captaincoder777/Airplane-custom-transmitter-and-receiver-/README.md

# Custom RC Aircraft System (Arduino Nano & NRF24L01)
A custom-built remote-controlled airplane made from scratch using 5mm sun Board runs on an srduino sano uses an NRF24L01 radio module for communication. The plane has a 3-channel control system that manages throttle through a brushed ESC via ailerons and pitch using the elevator. Everything is controlled from a hand-built ground station transmitter.

## Project Motivation

Most people jump into this hobby using made radio systems and foam planes i wanted to build everything from the ground up by designing both the aircraft and the transmitter by my self  learned how flight dynamics work , how wireless radios communicate , how microcontroller firmware operates , how to model parts in CAD and how to cut boards by hand i also got experience with power distribution , signal routing and fixing hardware problems during test flights.  

# CAD design
the build start from here 

this is where the aircraft comes to live 

this is final build 

the motor will slide here 

and is connected to receiver


airframe here thw sings have two ailerons which will move simultaneously mirrored when one is up other is down same other side which will help the aircraft to turn left ad right

the elevator helps the aircraft to pitch up and down 

## Receiver circuit and CAD
Screenshot 2026-10-31 at 6 50 51 PM

follow this path to connect the components

| Component | Pin | Connected To | 
| :-- | :-- | :-- |
| **NRF24L01** | VCC / VSS | Arduino 3.3V |
| **NRF24L01** | GND | Arduino GND |
| **NRF24L01** | CE | Arduino D7 |
| **NRF24L01** CSN | Arduino D8 |
| **NRF24L01** | MOSI | Arduino D11 |
| **NRF24L01** | MISO | Arduino D12 |
| **NRF24L01** | SCK | Arduino D13 |
| **Aileron Servo** | Signal | Arduino D2 |
| **Aileron Servo** |+/-| 5V Rail / GND |
| **Elevator Servo** | Signal | Arduino D4 |
| **Elevator Servo** |+/-| 5V Rail / GND |
| **Brushless ESC** | Signal | Arduino D5 |
| **Brushed ESC** | BEC Red | Arduino 5V |
|**Brushed ESC** | BEC Black | Arduino GND |

the full assembly will look like this 


held inside an enclosure which goes on board the flight

## Transmitter circuit and CAD
the transmitter i held in a box to make this look good


this is the final build has screws to hold them intact here the anteena nrf module and nano is one single component after build which can be kept and removed when necessary 
Screenshot 2026-10-31 at 6 55 05 PM
and batteries can be swapped 

the circuit design goes like this 

Screenshot 2026-10-31 at 6 57 54 PM

follow this path to solder 
| Component | Pin| Connected To |
| :-- | :-- | :-- |
| **NRF24L01** | VCC/VSS | Arduino 3.3V |
| **NRF24L01** | GND | Arduino GND |
| **NRF24L01** | CE | Arduino D7 |
| **NRF24L01** CSN | Arduino D8 |
| **NRF24L01** | MOSI | Arduino D11 |
| **NRF24L01** | MISO | Arduino D12 |
| **NRF24L01** | SCK | Arduino D13 |
| **Right Joystick (J1)** | VRX | Arduino A1 |
| **Right Joystick (J1)** | VRY Arduino A2 |
| **Right Joystick (J1)** | VCC / GND 5V / GND Rail |
| **Left Joystick (J2)** | VRY Arduino A0 |
| **Left Joystick (J2)** | VCC / GND 5V / GND Rail |

this is how the final build looks like 



## Airframe dimensions and CAD
follow this path for measurements 

be carefull while cutting through sun board as you need to use very sharp knife for this.  

| Component | Material | Dimension |
| :-- | :-- | :--
| **Fuselage Sides** | 5mm Sun Board | 50 cm length |
| **Main Wing Panel** | 5mm Sun Board |53 cm wingspan, 8 cm root chord |
| **Horizontal Stabilizer** | 5mm Sun Board | 28 cm span |
| **Vertical Fin** | 5mm Sun Board | 9–10 cm height |

# What goes where


this is final build 



keep the batteries either side to prevent the aircrft from loosing balance up in the air


place one servo near the elevator to help the pudh rod movement correct 

and other at middle to operate both ailerons 



### Control Surface & Hardware Setup

* I cut custom slots in the fuselage to hold two SG90 micro servos. I attached linkages stopper and push rods to the control horns on the ailerons and elevator.

* The 555 motor slide to the nose plate and power wires flow to the 30A ESC , which is mounted on the side wall.

* I placed the 7.4V LiPo battery far forward as possible to keep the center of gravity balanced for stable flight.

### Electronics Assembly Notes

* I soldered socket pins onto a pcb so the Arduino Nano and NRF24L01 could be inserted and removed without soldering.

* I added a 100uF capacitor across the power pins of the NRF24 module to prevent voltage drops.

* All the joystick pots, power input and radio output were wired inside the transmitter box.

## Firmware Setup

* Install the Arduino IDE.

* Use the built-in library manager to install the **RF24** library by TMRh20.

### Upload Procedure

Connect the transmitter Arduino Nano to your PC using USB.

in the Arduino IDE select Arduino Nano as the board Transmitter.ino` choose the correct COM port and click Upload.

swap the Nano board with the unit.

Open `Receiver.ino` confirm the board is correct and upload the code.

## Bill of Materials (BOM)

| Item | Quantity | Aprox. Cost | Link/Source |
| :-- | :-- | :-- | :-- |
| **Arduino Nano**| 2 | $3 | https://robocraze.com/products/nano-board-r3-compatible-with-arduino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|
| **NRF24L01 Transceiver**| 2 | $2 | https://robocraze.com/products/nrf24l01-pa-lna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 |
| **555 Brushed Motor**| 1 | $3 | https://robu.in/product/555-front-and-rear-ball-bearing-motors-dc-24v-12v-12000rpm/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|
| **30A Brushed ESC**| 1 | $7 | https://robu.in/product/30-a-brushed-esc-no-brake/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|
| **LiPo Battery (7.4V 2200 mAh)**| 1 | $1 | https://robocraze.com/products/3-7v-2000mah-18650-li-ion-battery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|
| **SG90 / MG90S Micro Servos**| 2 | $3 | https://robu.in/product/mg90s-9g-servo-metal-gear/ |
| **2-Axis Joystick Modules**| 2 | $1| https://robu.in/product/joystick-module-ps2-breakout-sensor/|
| **Sun Board (5mm)** | 1 Sheet | $7 | https://www.amazon.in/Foam-Board-Sun-Thickness-Size/dp/B0F2SYL8JF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|
| **100uF Capacitors** |2 | $2 | https://robu.in/product/100uf-250v-electrolytic-capacitor-dip-pack-of-2/|
| **Hardware & Linkages (Pushrods, Horns, Wires)**| 1 Set | $10 | https://robu.in/product/d1x700mm-z-type-push-pull-steel-rod-for-rc-aircraft-aero-modelling-2pcs/|
| **Total** | $40(aprox) | 

# Full working video

Video 1: https://youtu.be/rrU_qEG8W9A

Video 2 shows clearly how ailerons and elevator work.  

Video 2: https://youtu.be/Hg1TWhAzz4g

## Hard Lessons & Practical Fixes and Failure

* **Sun Board Snapping:** The 5mm Sun Board is strong under stress but it breaks very hard  at joints when it takes a hard hit nose dives often tear the glue points apart and this made my aircraft to fall off and everything snapped where ever possible.  

* **NRF Voltage Limits:** The NRF24L01 only works at 3.3V. powering it 5V will destroy it instantly(like i did) use 3.3V with capacitors for signal loss.

* **Transmitter Antenna Warning:** Never turn on the NRF module without attaching the antenna without the antenna the this will burn the modeul.
  
* **Power Dip Resets:** When both servos move at speed the power draw can cause the 5V line to drop below 4.2V which  resets the microcontroller add capacitors to avoid these brownouts.

# Credits
* **[Arduino](https://www.arduino.cc/)** - Microcontroller programming
* **[TMRh20 RF24](https://github.com/nRF24/RF24)** - Wireless communication library
* **[GrabCAD](https://grabcad.com/library)** - CAD electronic models for full CAD assembly
* **[Hack Club Forge](https://forge.hackclub.com/)** - For supporting projects in this format
