captaincoder777/Airplane-custom-transmitter-and-receiver-/Circuit/Receiver.png

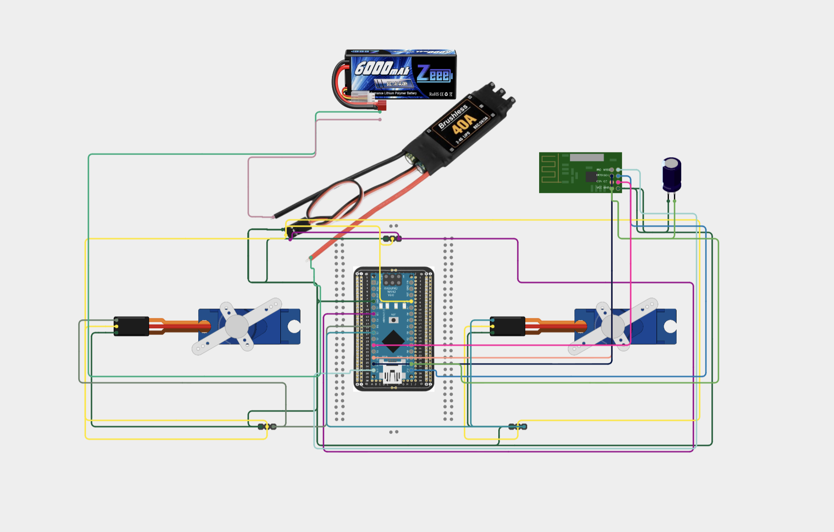
Circuit/Receiver.png
