captaincoder777/Airplane-custom-transmitter-and-receiver-/Circuit/Transmitter.png

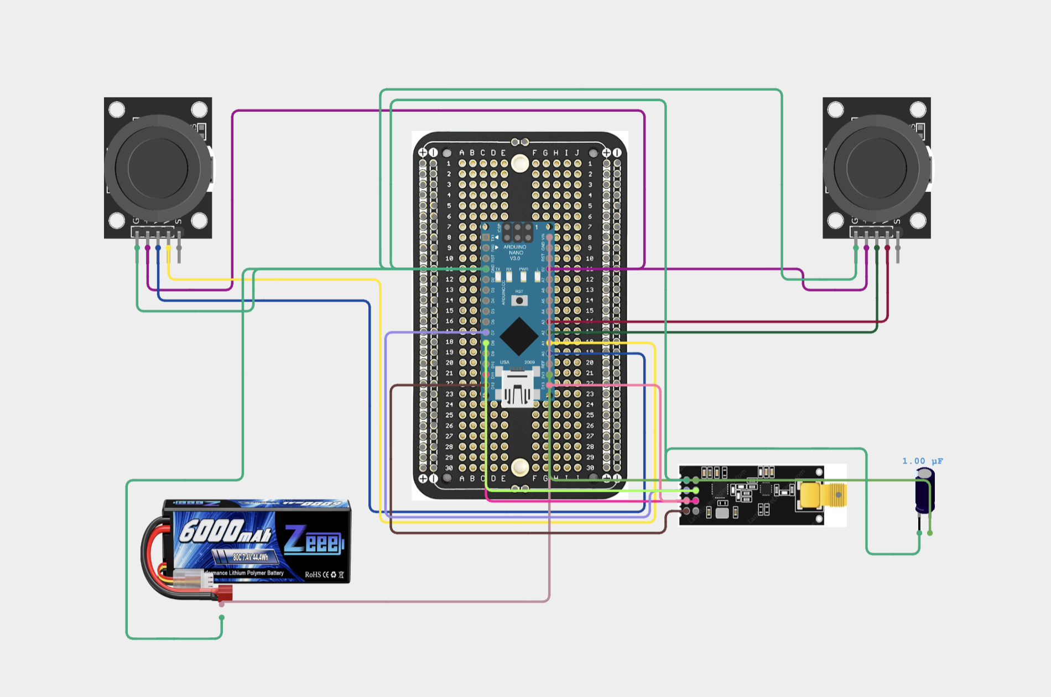
Circuit/Transmitter.png
