captaincoder777/Airplane-custom-transmitter-and-receiver-/CAD /Airframe CAD/Airplanedesign.step

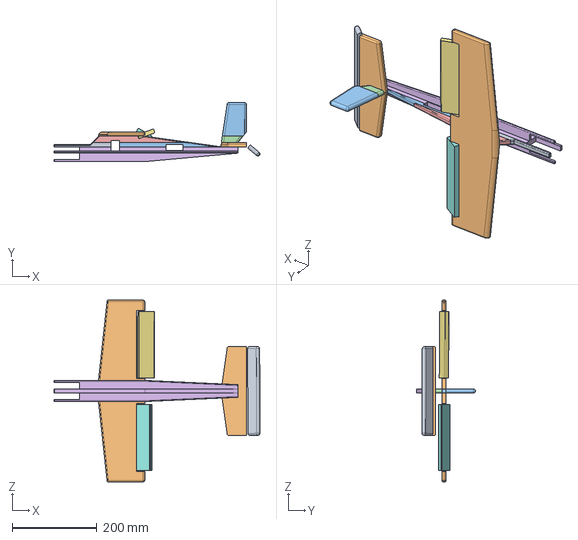
[picture p3: CAD file, 2026-10-31]
CAD /Airframe CAD/Airplanedesign.step
487.1 x 140.0 x 430.0 mm
