captaincoder777/Airplane-custom-transmitter-and-receiver-/CAD /Electronics CAD/Li-ion 18650.SLDPRT

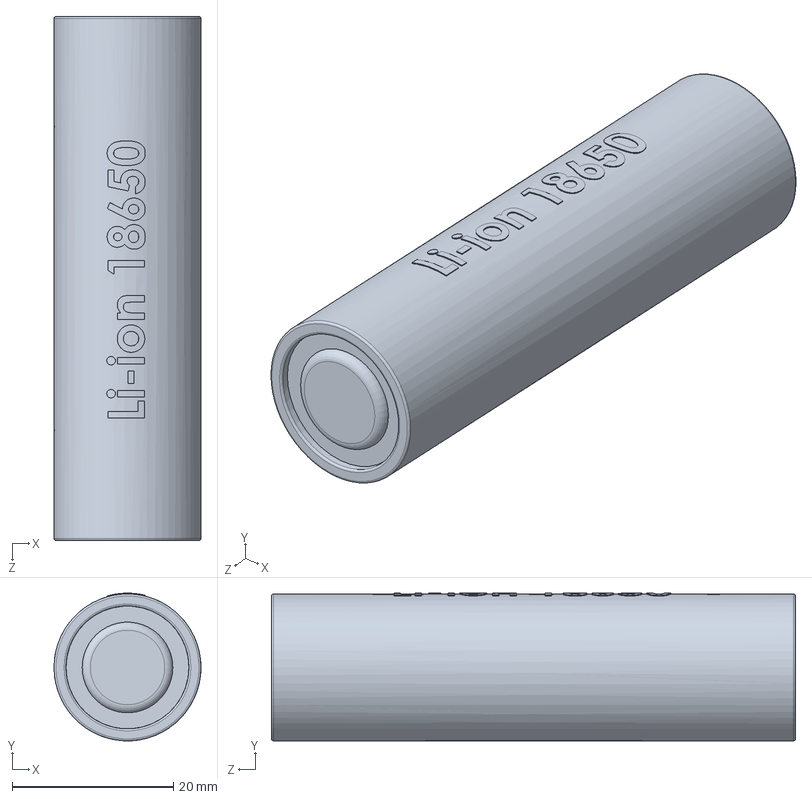
[picture p4: CAD file, 2026-10-31]
CAD /Electronics CAD/Li-ion 18650.SLDPRT
18.2 x 18.3 x 65.1 mm
