captaincoder777/Airplane-custom-transmitter-and-receiver-/CAD /Receiver CAD/Receiver.step

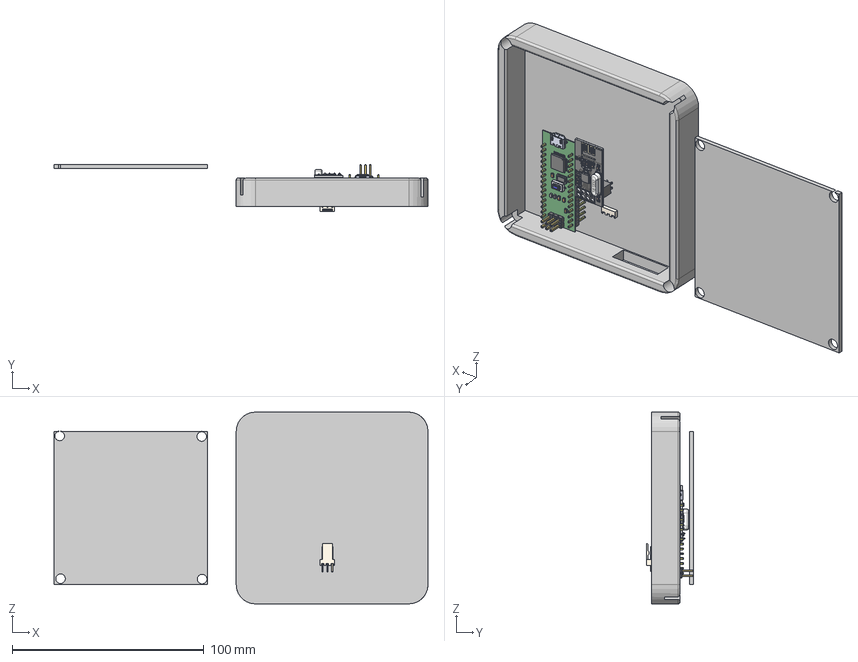
[picture p5: CAD file, 2026-10-31]
CAD /Receiver CAD/Receiver.step
195.0 x 24.5 x 100.0 mm
PCB
