captaincoder777/Airplane-custom-transmitter-and-receiver-/CAD /Transmitter CAD/Body.step

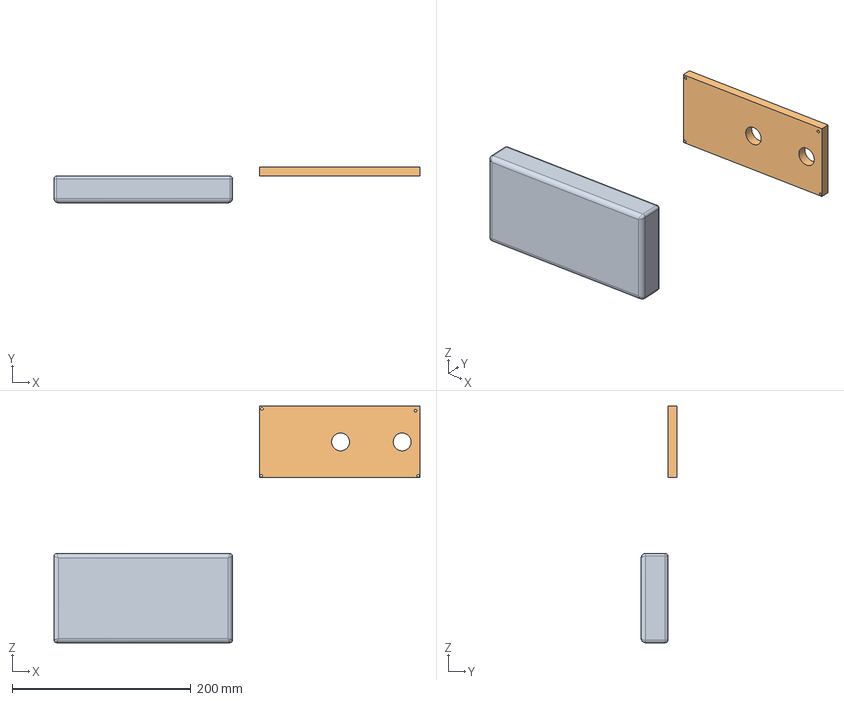
[picture p6: CAD file, 2026-10-31]
CAD /Transmitter CAD/Body.step
410.0 x 40.0 x 265.0 mm
