captaincoder777/Airplane-custom-transmitter-and-receiver-/CAD /Airframe CAD/Wing.step

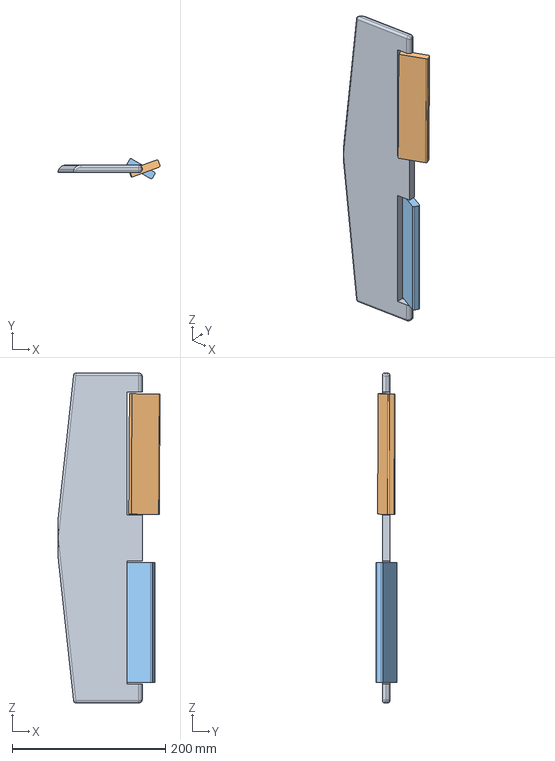
[picture p7: CAD file, 2026-10-31]
CAD /Airframe CAD/Wing.step
133.1 x 26.9 x 430.0 mm
