captaincoder777/Airplane-custom-transmitter-and-receiver-/CAD /Electronics CAD/PROPS.step

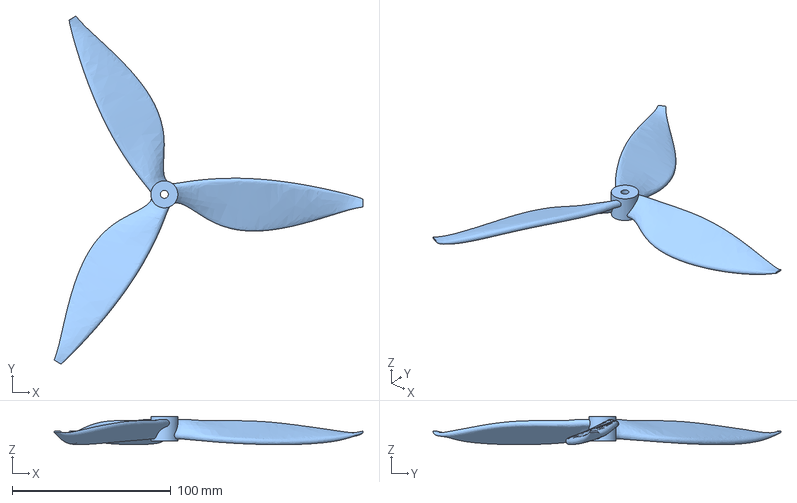
[picture p8: CAD file, 2026-10-31]
CAD /Electronics CAD/PROPS.step
194.4 x 219.0 x 17.9 mm
