captaincoder777/Airplane-custom-transmitter-and-receiver-/CAD /Receiver CAD/Body.step

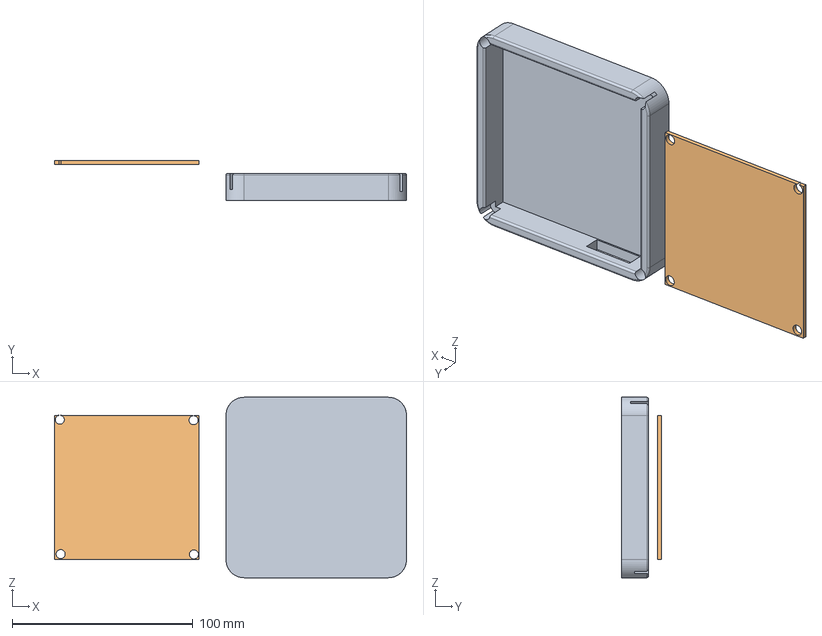
[picture p9: CAD file, 2026-10-31]
CAD /Receiver CAD/Body.step
195.0 x 22.0 x 100.0 mm
