captaincoder777/Airplane-custom-transmitter-and-receiver-/CAD /Transmitter CAD/Transmitter.step

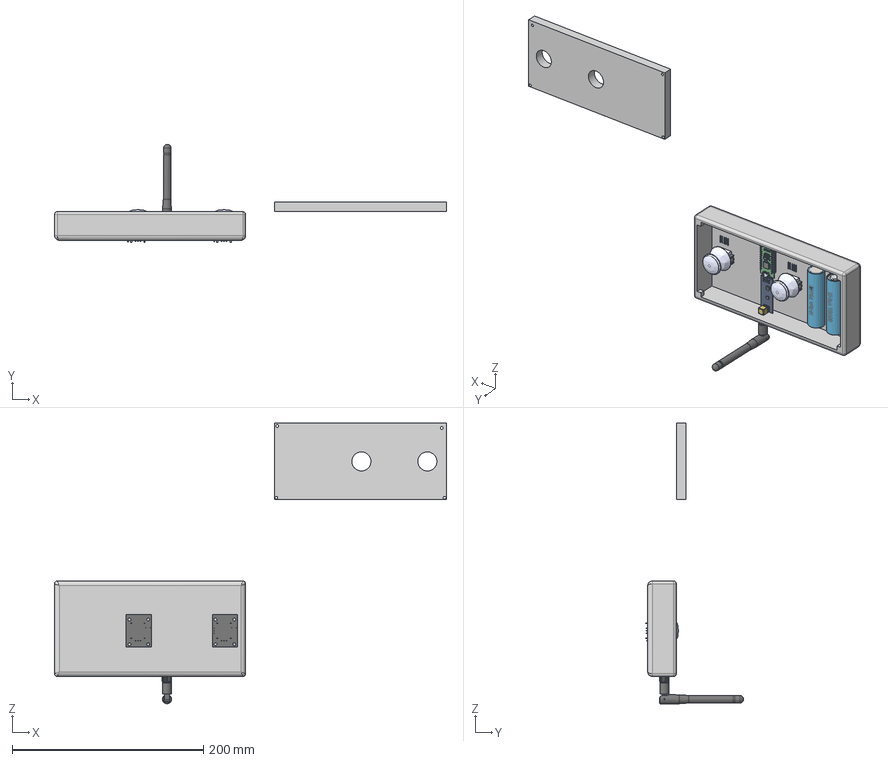
[picture p10: CAD file, 2026-10-31]
CAD /Transmitter CAD/Transmitter.step
410.0 x 102.9 x 293.5 mm
PCB
