captaincoder777/Airplane-custom-transmitter-and-receiver-/CAD /Airframe CAD/Rudder.step

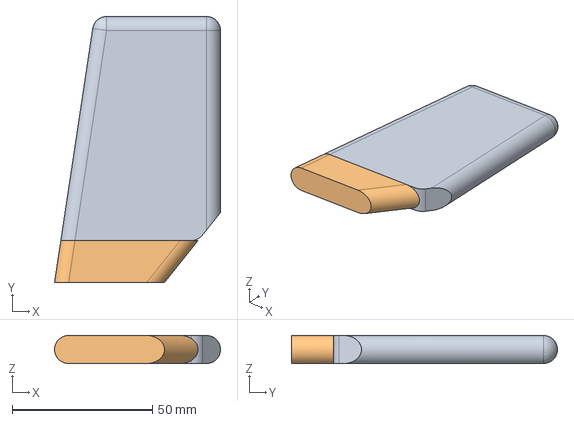
[picture p11: CAD file, 2026-10-31]
CAD /Airframe CAD/Rudder.step
59.3 x 95.0 x 10.0 mm
