captaincoder777/Airplane-custom-transmitter-and-receiver-/CAD /Electronics CAD/brushed esc.SLDPRT

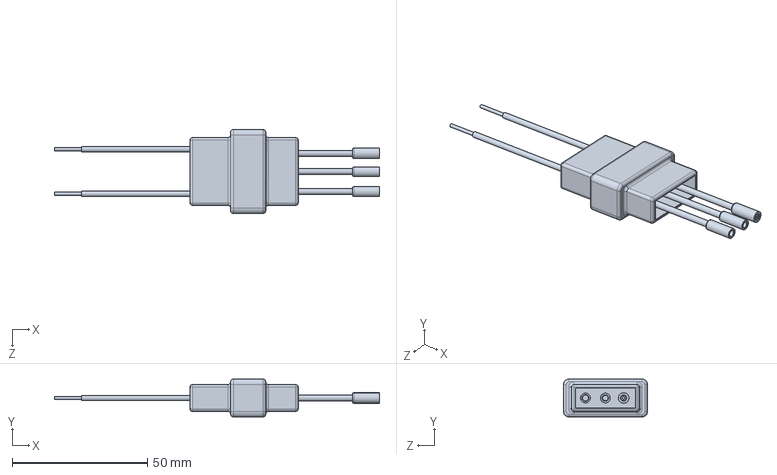
[picture p12: CAD file, 2026-10-31]
CAD /Electronics CAD/brushed esc.SLDPRT
120.0 x 14.0 x 31.0 mm
