captaincoder777/Airplane-custom-transmitter-and-receiver-/CAD /Airframe CAD/Fuselage.step

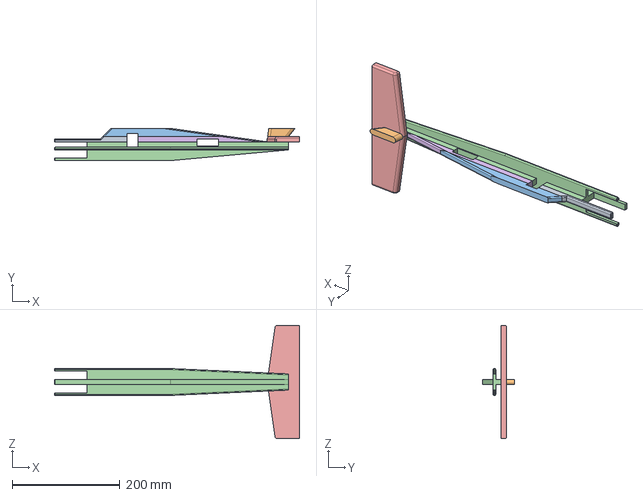
[picture p13: CAD file, 2026-10-31]
CAD /Airframe CAD/Fuselage.step
455.0 x 60.0 x 210.0 mm
