captaincoder777/Airplane-custom-transmitter-and-receiver-/CAD /Electronics CAD/Micro_Servo_9g-v5.step

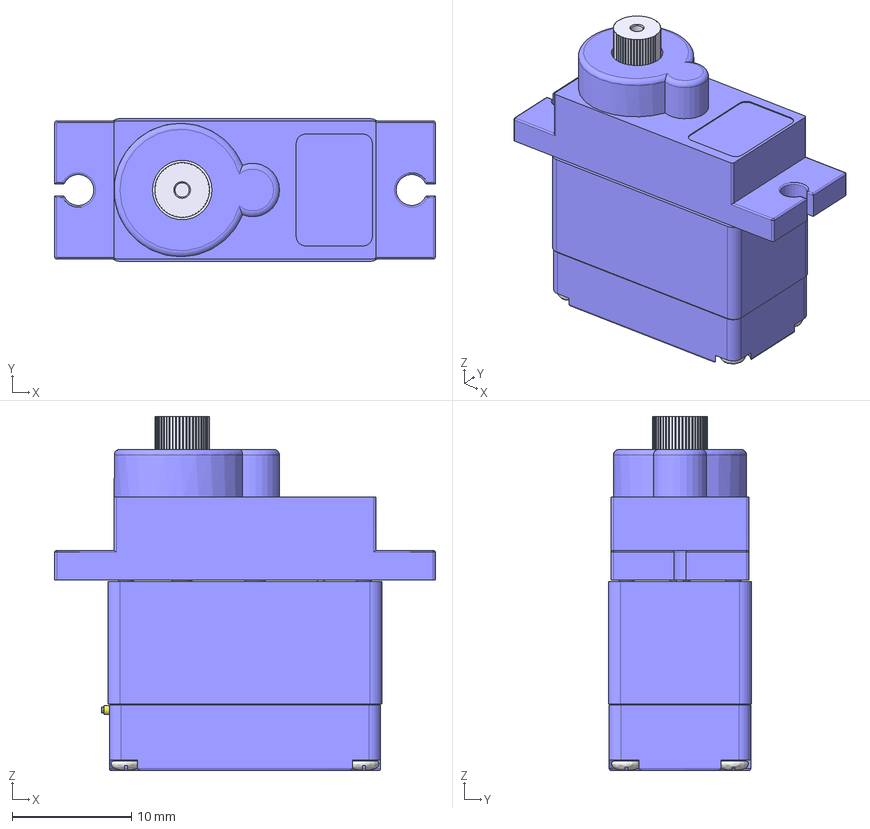
[picture p14: CAD file, 2026-10-31]
CAD /Electronics CAD/Micro_Servo_9g-v5.step
32.0 x 12.0 x 29.8 mm
Body_up
Body_mid
Body_btm
Axis_001
Screw_001
Screw_002
Screw_003
Screw_004
Axis
Hare
Rivet_001
Rivet_002
Rivet_003
Conn_001
Conn_002
Conn_003
Resist
Conn_004
Conn_005
Rivet_004
Rivet_005
Washer_001
Washer_002
Board_001
Metal_001
Metal_002
Silk_001
Silk_002
Pins_001
Pins_002
Pins_003
Pins_004
Pins_005
Pins_006
Pins_007
Pins_008
ShapeString
Pin_004
Pin_005
Pin_006
ShapeString002
Pin_007
Pin_008
Pin_009
ShapeString003
Pin_010
Pin_011
Pin_012
ShapeString004
Pin_001
Pin_002
Pin_003
ShapeString001
contact033
contact034
contact025
contact026
contact027
contact028
contact029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
