captaincoder777/Airplane-custom-transmitter-and-receiver-/CAD /Electronics CAD/RF NRF24L01 2.4Ghz_PIN.stp

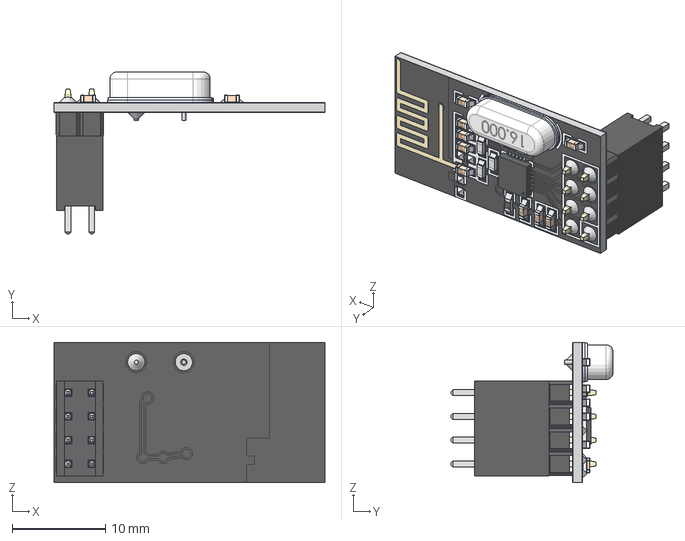
[picture p15: CAD file, 2026-10-31]
CAD /Electronics CAD/RF NRF24L01 2.4Ghz_PIN.stp
29.0 x 17.3 x 15.0 mm
header_2.54_female_2x4pin
RF NRF24L01 2.4Ghz_1
