captaincoder777/Airplane-custom-transmitter-and-receiver-/CAD /Electronics CAD/RS-385 DC12V  Mini Brush DC Motor.step

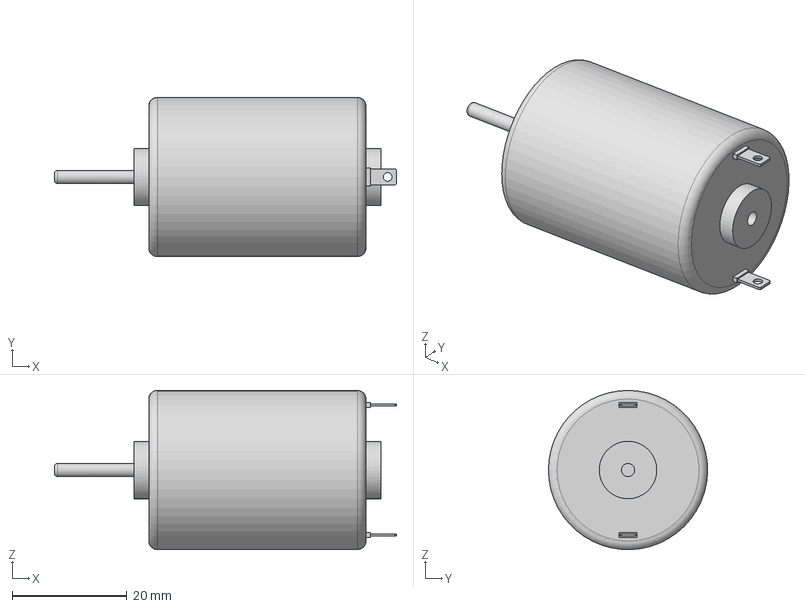
[picture p16: CAD file, 2026-10-31]
CAD /Electronics CAD/RS-385 DC12V Mini Brush DC Motor.step
59.5 x 27.7 x 27.7 mm
