captaincoder777/Airplane-custom-transmitter-and-receiver-/CAD /Electronics CAD/PCB1.step

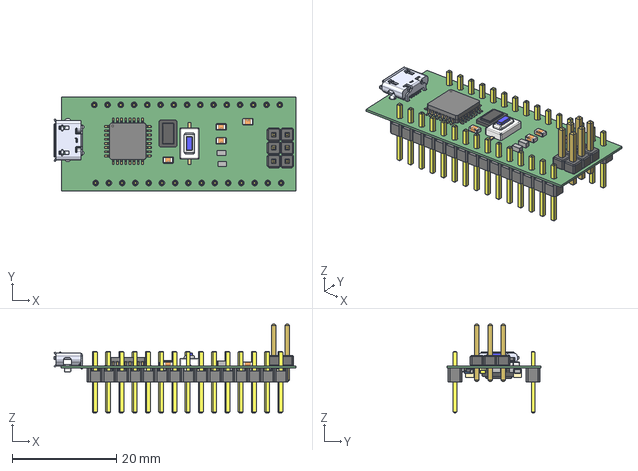
[picture p17: CAD file, 2026-10-31]
CAD /Electronics CAD/PCB1.step
46.4 x 18.0 x 17.0 mm
