captaincoder777/Airplane-custom-transmitter-and-receiver-/(list of files, cad)

Other CAD files:
CAD /Airframe CAD/Airplanedesign Electronics.f3z
CAD /Airframe CAD/Airplanedesign.f3z
CAD /Airframe CAD/Fuselage.f3z
CAD /Airframe CAD/Rudder.f3z
CAD /Airframe CAD/wing.f3z
CAD /Electronics CAD/Arduino NANO.f3d
CAD /Electronics CAD/RS385 DC12V Mini Brush DC Motor.f3d
CAD /Receiver CAD/Body.f3z
CAD /Receiver CAD/Receiver.f3z
CAD /Transmitter CAD/Body.f3z
CAD /Transmitter CAD/Transmitter.f3z
