captaincoder777/Airplane-custom-transmitter-and-receiver-/(commit log)

2026-10-31 added cad an other files
2026-10-31 Revise README with project details and assembly notes
    Updated project details, added motivation, circuit diagrams, assembly notes, firmware setup, and BOM. Included hard lessons learned during the project.
2026-10-31 added BOM
2026-10-31 Fix formatting in BOM.CSV
    Updated the BOM.CSV to correct formatting and punctuation in the Hardware & Linkages entry.
2026-10-31 Revise BOM.CSV format and update costs
    Updated BOM.CSV to reflect cost in USD and cleaned up links.
2026-10-31 Change cost format to currency in BOM.CSV
    Updated cost format from numeric to currency format for clarity.
